OpenThingsIO/LEDSphere/Hardware/Arc for PCB.stl

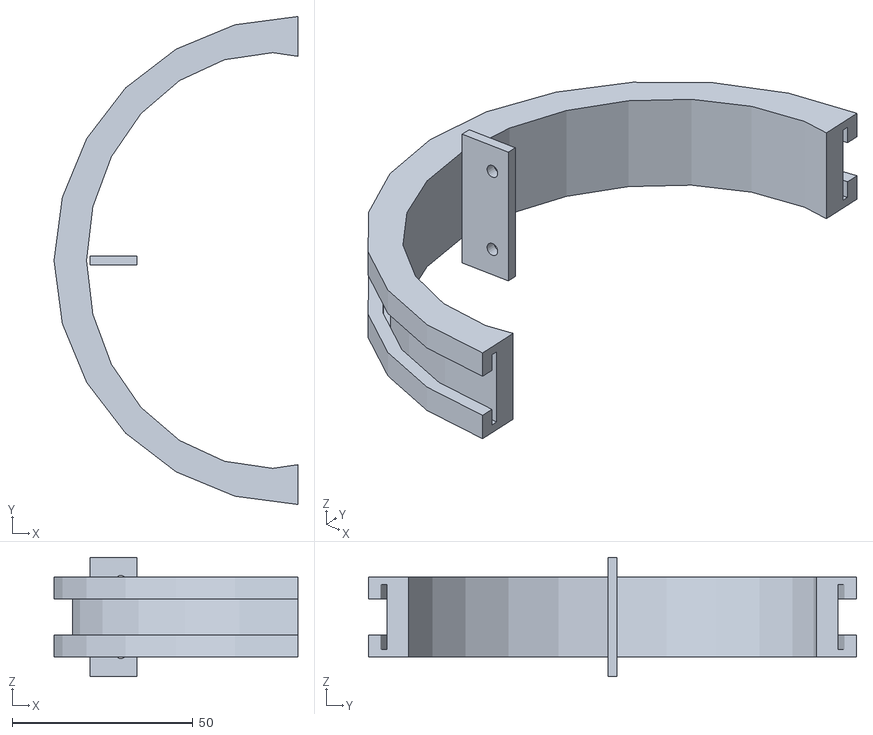
[picture p1: CAD file, 2020-01-08]
Hardware/Arc for PCB.stl
67.5 x 135.0 x 33.0
