OpenThingsIO/LEDSphere/Hardware/TopPCB.brd

## EAGLE design Hardware/TopPCB.brd (2020-01-07)

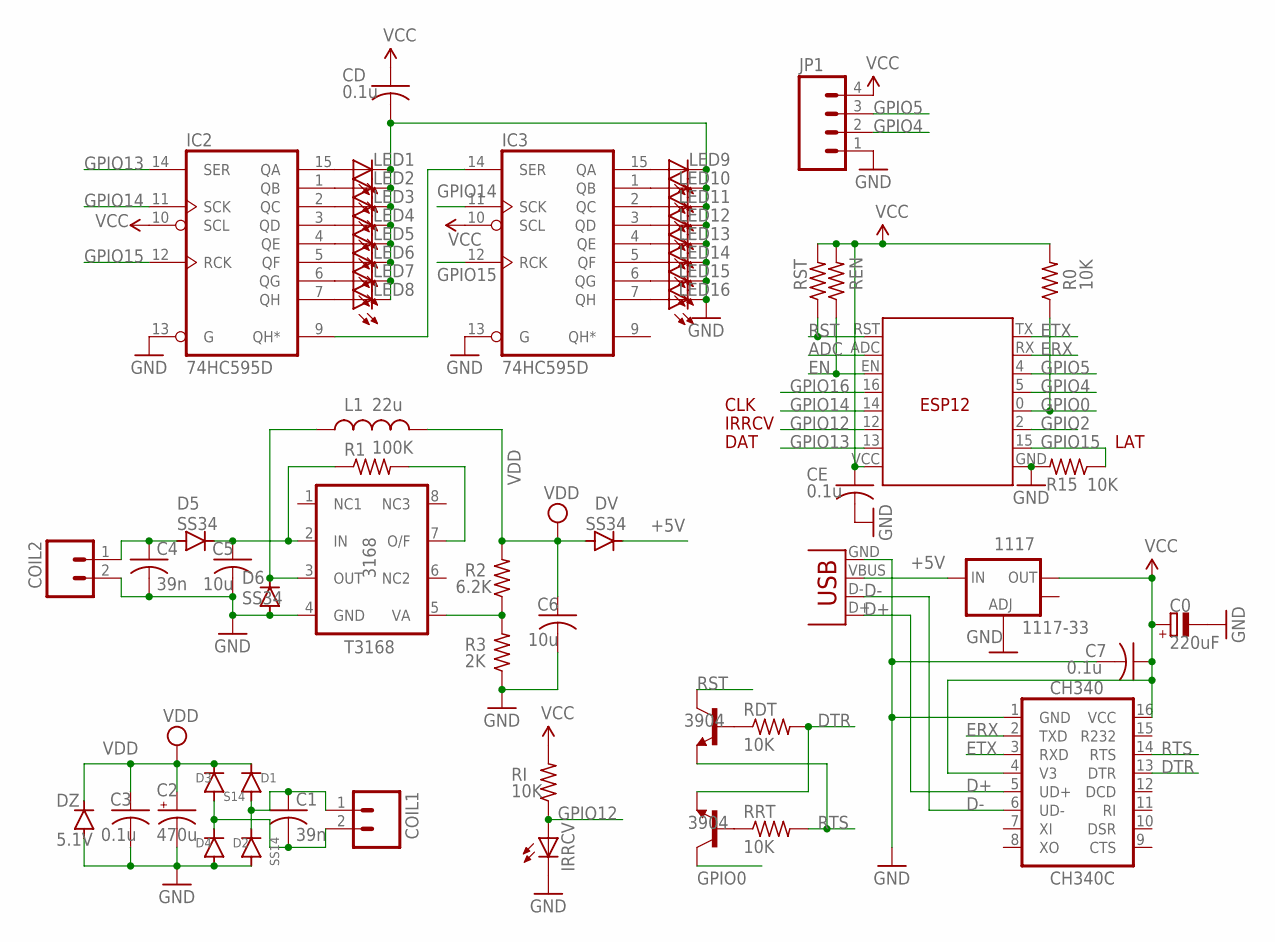
[picture p2: schematic TopPCB.sch]

Parts:
1117: 1117-33; SOT223
3168: T3168; SO08
C0: 220uF; CT3528
C1, C4: 39n; C0805K
C2: 470u; E2,5-6
C3: 0.1u; C0805K
C5, C6: 10u; C0805K
C7: 0.1u; C0603K
CD: 0.1u; C0603K
CE: 0.1u; C0603K
CH340: CH340C; SO16
COIL1, COIL2: M021X02_NO_SILK; 1X02_NO_SILK
D1: S14; DO-214AC
D2, D3, D4: SS14; DO-214AC
D5, D6: SS34; DO-214AC
DV: SS34; DO-214AC
DZ: 5.1V; MINIMELF
ESP: ESP; ESP12
IC2, IC3: 74HC595D; SO16
IRRCV: LED3MM
JP1: M041X04_NO_SILK; 1X04_NO_SILK
L1: 22u; CR54
LED1, LED2, LED3, LED4, LED5, LED6, LED7, LED8, LED9, LED10, LED11, LED12, LED13, LED14, LED15, LED16: LEDCHIPLED_0805; CHIPLED_0805
R0, R15: 10K; R0603
R1: 100K; R0603
R2: 6.2K; R0603
R3: 2K; R0603
RDT: 10K; R0603
REN: 10K; R0603
RI: 10K; R0603
RRT: 10K; R0603
RST: 10K; R0603
T1, T2: 3904; SOT23-BEC
X3: USBMICROB2; USB-MICROB2

Connections:
+5V: 1117.3 (IN), DV.C, X3.VBUS
ADC: ESP.ADC
D+: CH340.5 (UD+), X3.D+
D-: CH340.6 (UD-), X3.D-
DTR: CH340.13 (DTR), RDT.2, T2.E
EN: ESP.EN, REN.1
ERX: CH340.2 (TXD), ESP.RX
ETX: CH340.3 (RXD), ESP.TX
GND: 1117.1 (ADJ), 3168.4 (GND), C0.-, C2.-, C3.2, C4.2, C5.2, C6.2, C7.2, CD.2, CE.2, CH340.1 (GND), COIL2.2, D2.A, D4.A, D6.A, DZ.A, ESP.GND, IC2.8 (GND), IC2.13 (G), IC3.8 (GND), IC3.13 (G), IRRCV.K (C), JP1.1, LED1.C, LED2.C, LED3.C, LED4.C, LED5.C, LED6.C, LED7.C, LED8.C, LED9.C, LED10.C, LED11.C, LED12.C, LED13.C, LED14.C, LED15.C, LED16.C, R3.1, R15.2, X3.GND
GPIO0: ESP.0 (G0), R0.1, T2.C
GPIO2: ESP.2 (G2)
GPIO4: ESP.5 (G5), JP1.2
GPIO5: ESP.4 (G4), JP1.3
GPIO12: ESP.12 (G12), IRRCV.A, RI.1
GPIO13: ESP.13 (G13), IC2.14 (SER)
GPIO14: ESP.14 (G14), IC2.11 (SCK), IC3.11 (SCK)
GPIO15: ESP.15 (G15), IC2.12 (RCK), IC3.12 (RCK), R15.1
GPIO16: ESP.16 (G16)
unnamed: 3168.7 (O/F), R1.2
unnamed: C1.2, COIL1.2, D3.A, D4.C
unnamed: C4.1, COIL2.1, D5.A
unnamed: 3168.2 (IN), C5.1, D5.C, R1.1
unnamed: IC2.1 (QB), LED2.A
unnamed: C1.1, COIL1.1, D1.A, D2.C
unnamed: 3168.5 (VA), R2.1, R3.2
unnamed: 3168.3 (OUT), D6.C, L1.P$1 (1)
unnamed: IC2.15 (QA), LED1.A
unnamed: IC2.2 (QC), LED3.A
unnamed: IC2.3 (QD), LED4.A
unnamed: RDT.1, T1.B
unnamed: RRT.1, T2.B
unnamed: IC2.4 (QE), LED5.A
unnamed: IC2.5 (QF), LED6.A
unnamed: IC2.6 (QG), LED7.A
unnamed: IC2.7 (QH), LED8.A
unnamed: IC3.15 (QA), LED9.A
unnamed: IC3.1 (QB), LED10.A
unnamed: IC3.2 (QC), LED11.A
unnamed: IC3.3 (QD), LED12.A
unnamed: IC3.4 (QE), LED13.A
unnamed: IC3.5 (QF), LED14.A
unnamed: IC3.6 (QG), LED15.A
unnamed: IC3.7 (QH), LED16.A
unnamed: IC2.9 (QH*), IC3.14 (SER)
RST: ESP.RST, RST.1, T1.C
RTS: CH340.14 (RTS), RRT.2, T1.E
VCC: 1117.2 (OUT), C0.+, C7.1, CD.1, CE.1, CH340.4 (V3), CH340.16 (VCC), ESP.VCC, IC2.10 (SCL), IC2.16 (VCC), IC3.10 (SCL), IC3.16 (VCC), JP1.4, R0.2, REN.2, RI.2, RST.2
VDD: C2.+, C3.1, C6.1, D1.C, D3.C, DV.A, DZ.C, L1.P$2 (2), R2.2

Notes on the sheet:
IRRCV
DAT
CLK
LAT

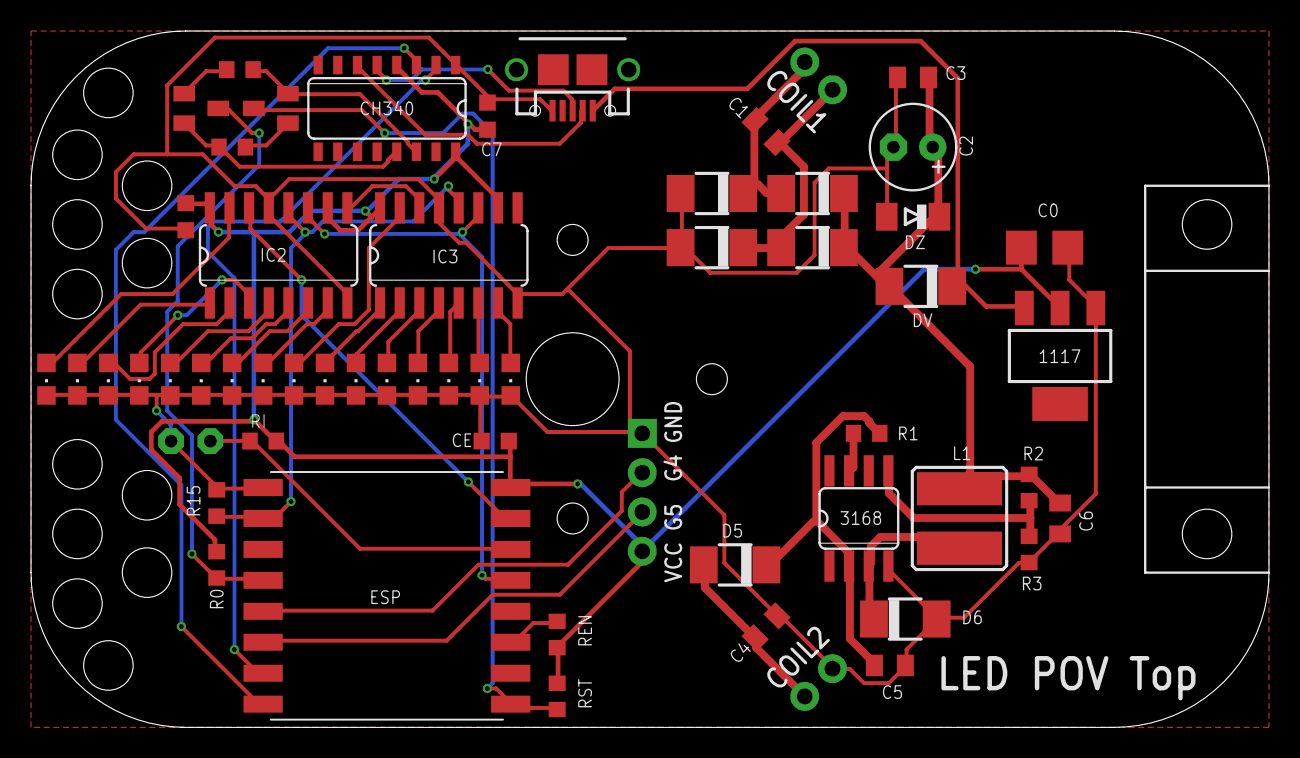
[picture p3: board TopPCB.brd from above]

Board: 2 copper layers, 80.0 x 45.0 mm, 58 parts (1 on the bottom side), 45 nets.
