OpenThingsIO/LEDSphere/Hardware/BasePCB.brd

## EAGLE design Hardware/BasePCB.brd (2020-01-07)

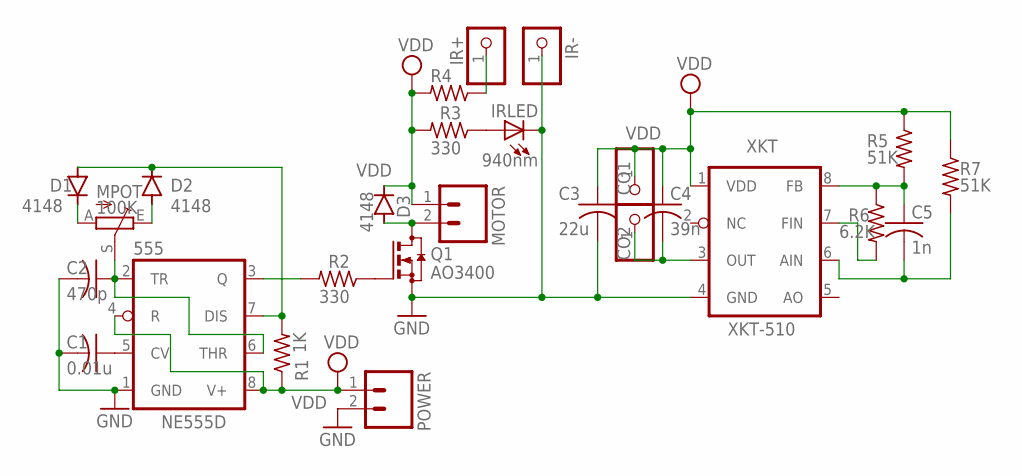
[picture p4: schematic BasePCB.sch]

Parts:
555: NE555D; SO08
C1: 0.01u; C0603K
C2: 470p; C0603K
C3: 22u; C0805K
C4: 39n; C0805K
C5: 1n; C0805K
CO1, CO2: PINHD-1X1CB; 1X01-CLEANBIG
D1, D2, D3: 4148; MINIMELF
IR+: PINHD-1X1CB; 1X01-CLEANBIG
IR-: PINHD-1X1CB; 1X01-CLEANBIG
IRLED: 940nm; CHIPLED_0603
MOTOR: M021X02_NO_SILK; 1X02_NO_SILK
MPOT: 100K; CA6V
POWER: M021X02_NO_SILK; 1X02_NO_SILK
Q1: AO3400; SOT23
R1: 1K; R0603
R2, R3, R4: 330; R0603
R5, R7: 51K; R0603
R6: 6.2K; R0603
XKT: XKT-510; SO08

Connections:
GND: 555.1 (GND), C1.2, C2.2, C3.2, IR-.1, IRLED.C, POWER.2, Q1.2 (S), XKT.4 (GND)
unnamed: 555.5 (CV), C1.1
unnamed: D1.C, MPOT.A
unnamed: 555.3 (Q), R2.2
unnamed: 555.2 (TR), 555.6 (THR), C2.1, MPOT.S
unnamed: D2.A, MPOT.E
unnamed: 555.7 (DIS), D1.A, D2.C, R1.2
unnamed: Q1.1 (G), R2.1
unnamed: D3.A, MOTOR.2, Q1.3 (D)
unnamed: IRLED.A, R3.1
unnamed: IR+.1, R4.1
unnamed: C5.1, R5.2, R6.1, XKT.8 (FB)
unnamed: C4.2, CO2.1, XKT.3 (OUT)
unnamed: C5.2, R7.2, XKT.6 (AIN)
unnamed: R6.2, XKT.7 (FIN)
VDD: 555.4 (R), 555.8 (V+), C3.1, C4.1, CO1.1, D3.C, MOTOR.1, POWER.1, R1.1, R3.2, R4.2, R5.1, R7.1, XKT.1 (VDD)

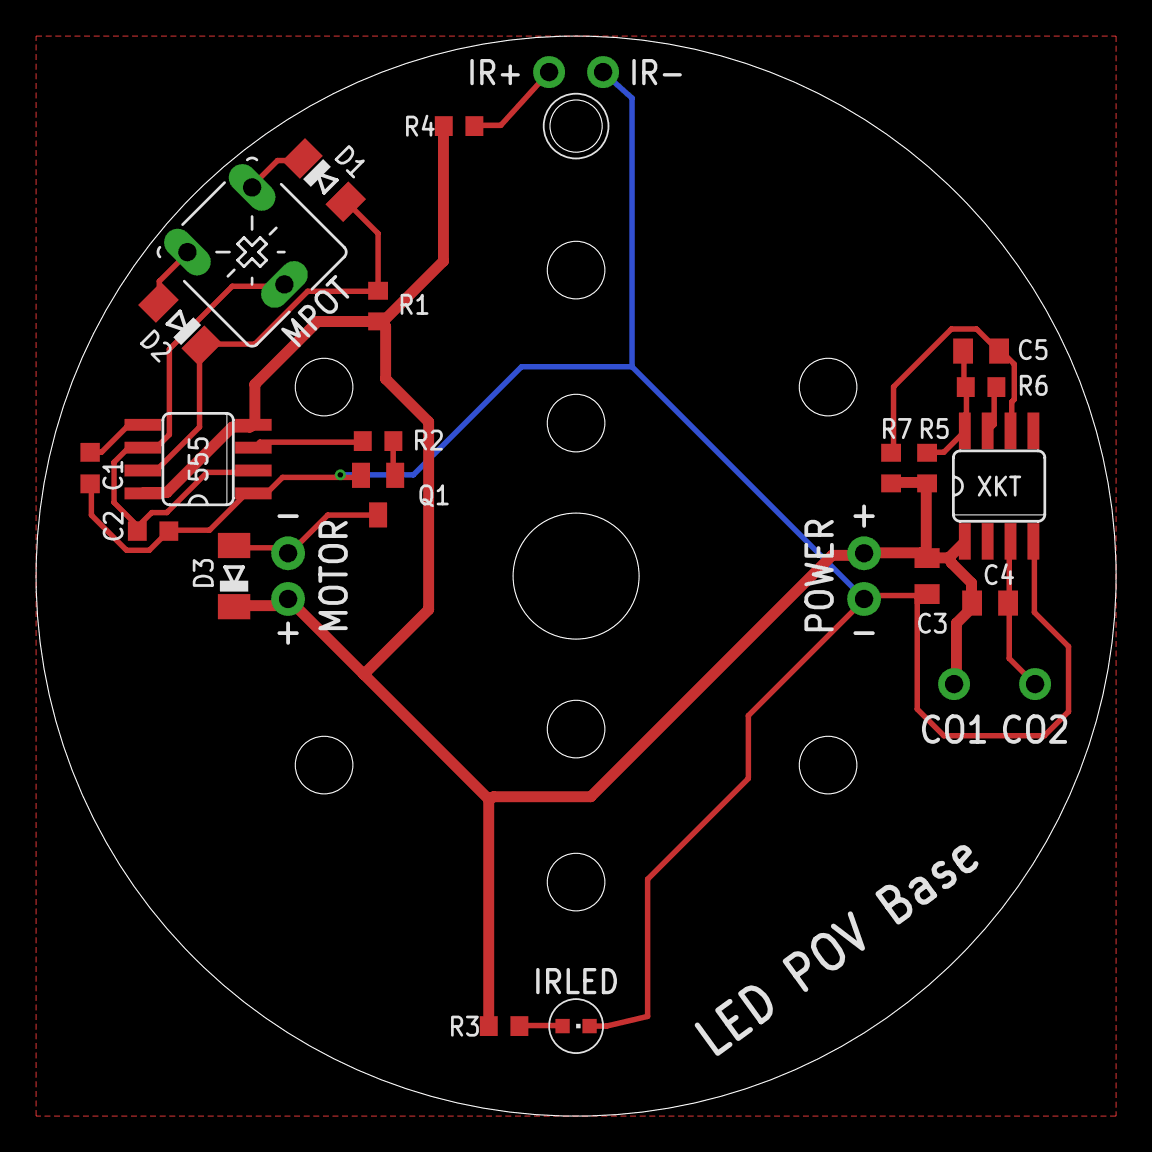
[picture p5: board BasePCB.brd from above]

Board: 2 copper layers, 60.0 x 60.0 mm, 26 parts (0 on the bottom side), 16 nets.
