OpenThingsIO/LEDSphere/LEDSphereDemo/defines.h

char ssid[] = "freefly";
char pass[] = "lrtsucks";
const char auth[] = "QNI95ZLfsquXuc3lKoa4SXkOnKFppa10";

#define IRRCV D5
#define LED D4
#define NEOP D6
#define NUM_NEOPS 12
#define NUMCOLS 64
#define BUFSIZE (NUM_NEOPS*NUMCOLS)
