OpenThingsIO/LEDSphere/(commit log)

2020-01-07 add first version of PCB design
    [BasePCB.brd, BasePCB.sch, TopPCB.brd, TopPCB.sch]
2020-01-08 stl file: prototype for the arc
    prototype with a slit to slide the LED strip into. This also has a tiny piece so that it can be screwed onto the top PCB. It can be made thinner (to use less plastic per print) but this is just to see what changes are needed.
    [Arc for PCB.stl]
